notmart/terminalmodelmtousb/freecad/Top.stl

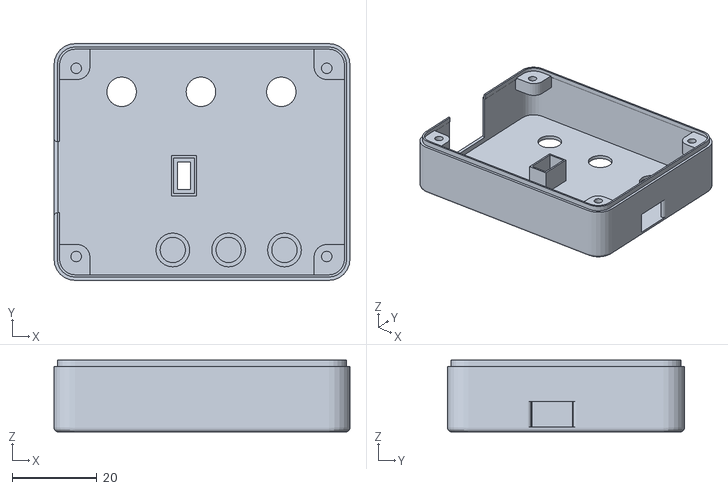
[picture p1: CAD file, 2021-06-11]
freecad/Top.stl
70.0 x 56.0 x 17.0
