notmart/terminalmodelmtousb/kicad/modelMterminalAdapter.step

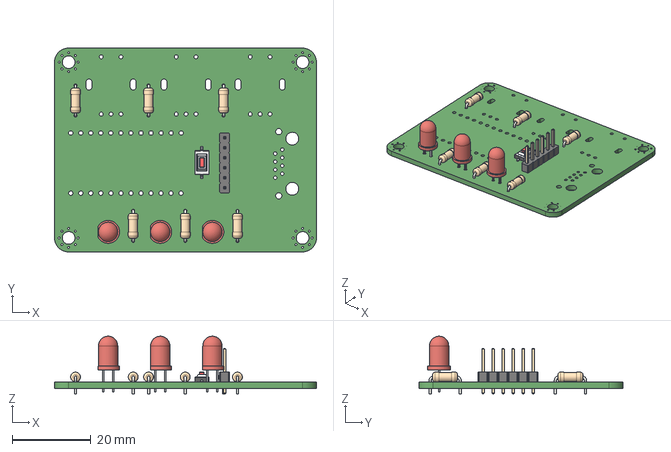
[picture p2: CAD file, 2021-05-25]
kicad/modelMterminalAdapter.step
66.3 x 51.6 x 14.6 mm
