notmart/terminalmodelmtousb/freecad/Bottom.stl

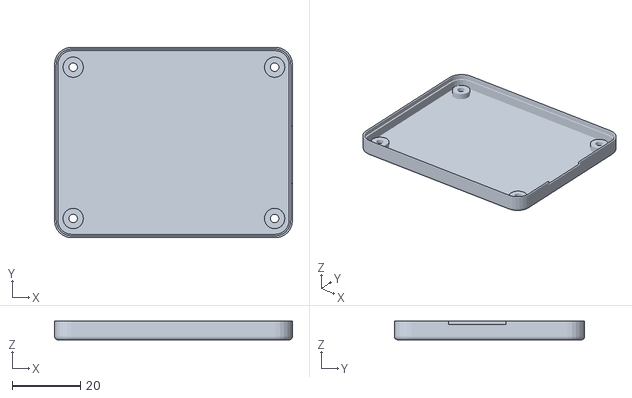
[picture p3: CAD file, 2021-06-11]
freecad/Bottom.stl
70.0 x 56.0 x 5.50
