notmart/terminalmodelmtousb/freecad/case.FCStd

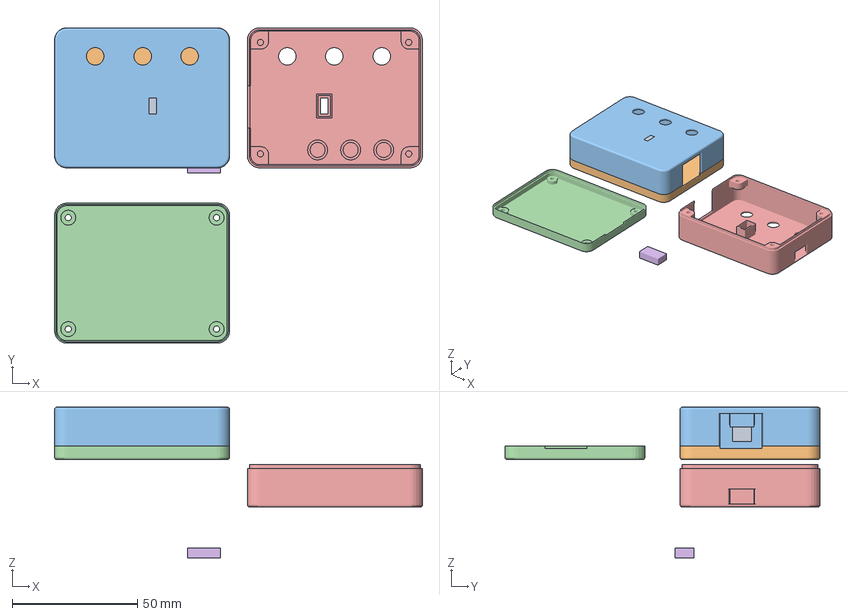
[picture p4: CAD file, 2021-06-11]
freecad/case.FCStd
147.0 x 126.0 x 60.2 mm
ResetButton
Bottom
Top
Bottom (Meshed)
Top (Meshed)
ResetButton (Meshed)
