notmart/terminalmodelmtousb/freecad/ResetButton.stl

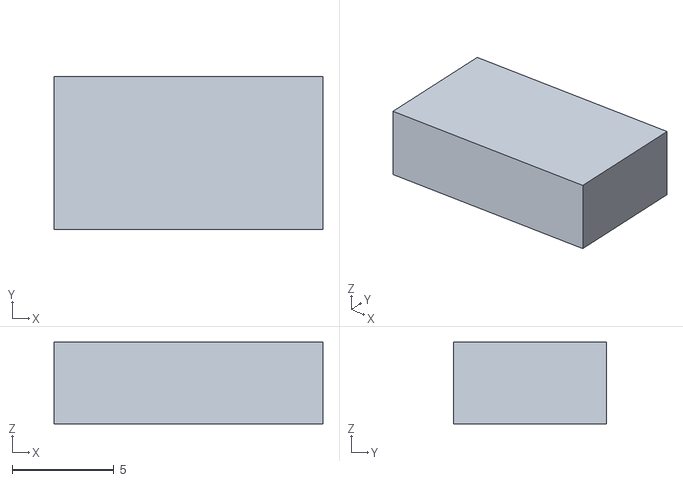
[picture p5: CAD file, 2021-06-11]
freecad/ResetButton.stl
13.2 x 7.50 x 4.00
