notmart/terminalmodelmtousb/kicad/modelMterminalAdapter.kicad_pcb

## KiCad design kicad/modelMterminalAdapter.kicad_pcb (2021-05-25)

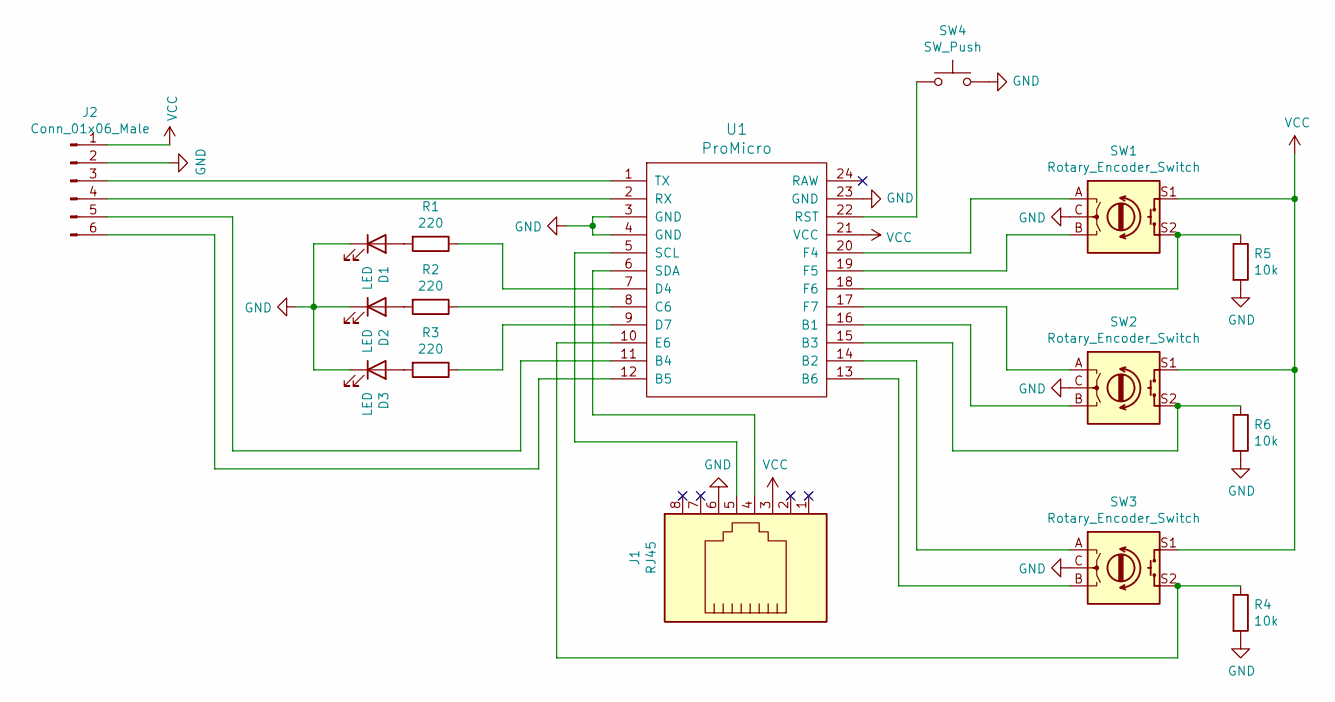
[picture p6: schematic modelMterminalAdapter.sch]

Parts:
D1, D2, D3: LED; LED_D5.0mm
J1: RJ45; RJ45_Amphenol_RJHSE5380
J2: Conn_01x06_Male; PinHeader_1x06_P2.54mm_Vertical
R1, R2, R3: 220; R_Axial_DIN0207_L6.3mm_D2.5mm_P7.62mm_Horizontal
R4, R5, R6: 10k; R_Axial_DIN0207_L6.3mm_D2.5mm_P7.62mm_Horizontal
SW1, SW2, SW3: Rotary_Encoder_Switch; RotaryEncoder_Alps_EC11E-Switch_Vertical_H20mm
SW4: SW_Push; SW_SPST_CK_RS282G05A3
U1: ProMicro

Connections:
GND: D1.1 (K), D2.1 (K), D3.1 (K), J1.6, J2.2, R4.2, R5.2, R6.2, SW1.C, SW2.C, SW3.C, SW4.2, U1.3 (GND), U1.4 (GND), U1.23 (GND)
unnamed: D1.2 (A), R1.2
unnamed: D2.2 (A), R2.2
unnamed: D3.2 (A), R3.2
unnamed: J1.4, U1.6 (SDA)
unnamed: J1.5, U1.5 (SCL)
unnamed: J2.3, U1.1 (TX)
unnamed: J2.4, U1.2 (RX)
unnamed: J2.5, U1.11 (B4)
unnamed: J2.6, U1.12 (B5)
unnamed: R1.1, U1.7 (D4)
unnamed: R2.1, U1.8 (C6)
unnamed: R3.1, U1.9 (D7)
unnamed: R4.1, SW3.S2, U1.10 (E6)
unnamed: R5.1, SW1.S2, U1.18 (F6)
unnamed: R6.1, SW2.S2, U1.15 (B3)
unnamed: SW1.A, U1.20 (F4)
unnamed: SW1.B, U1.19 (F5)
unnamed: SW2.A, U1.17 (F7)
unnamed: SW2.B, U1.16 (B1)
unnamed: SW3.A, U1.14 (B2)
unnamed: SW3.B, U1.13 (B6)
unnamed: SW4.1, U1.22 (RST)
VCC: J1.3, J2.1, SW1.S1, SW2.S1, SW3.S1, U1.21 (VCC)

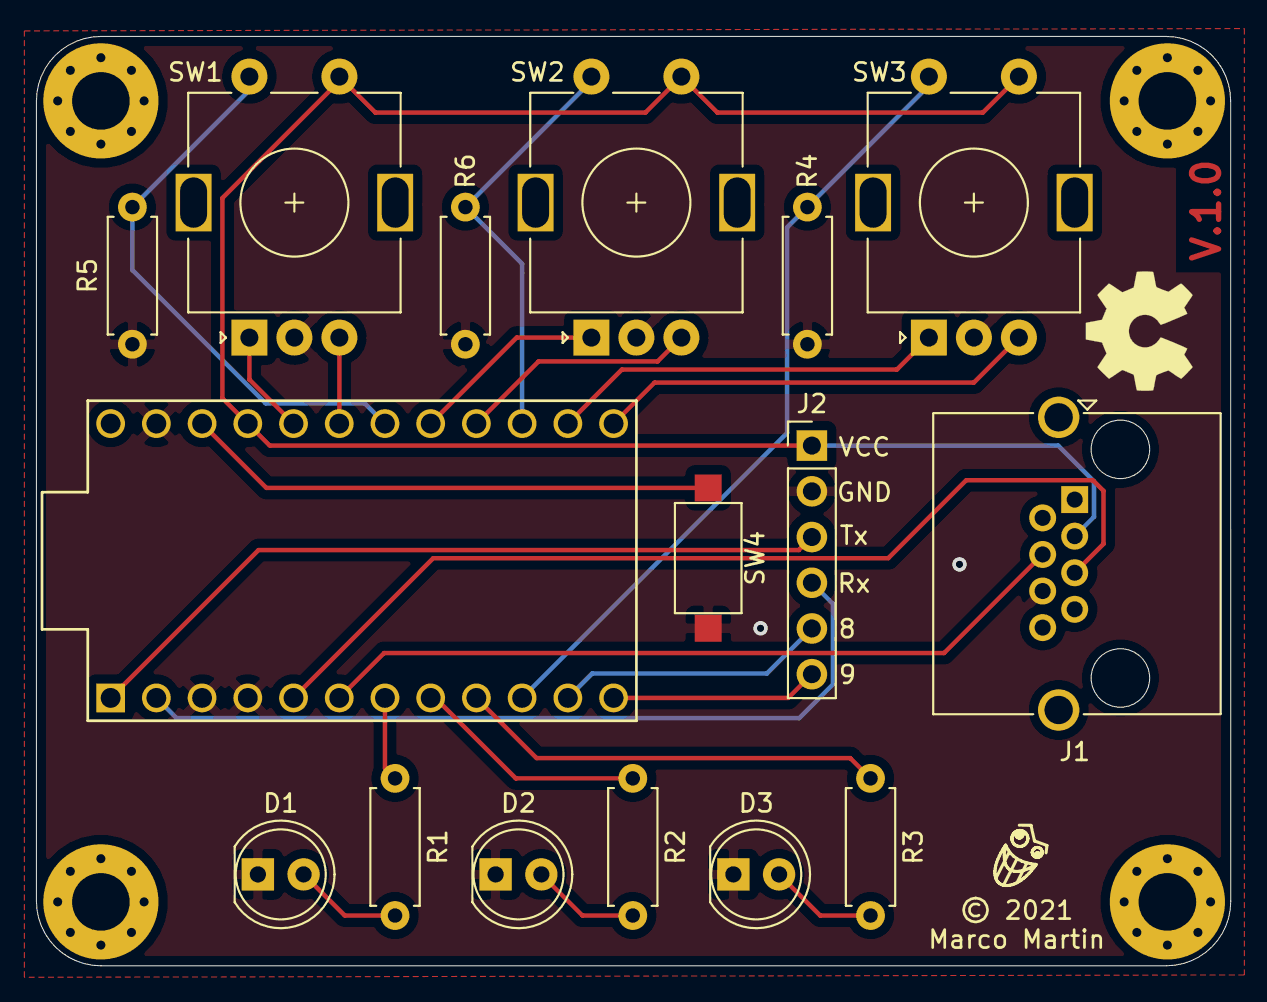
[picture p7: board modelMterminalAdapter.kicad_pcb from above]

Board: 2 copper layers, 66.4 x 51.6 mm, 20 parts (0 on the bottom side), 24 nets.

Other parts of the board:
mount1, mount2, mount3, mount4: MountingHole_3.2mm_M3_Pad_Via
