notmart/terminalmodelmtousb/terminalmodelmtousb.ino

/*
 *   Copyright 2021 Marco Martin <mart@kde.org>
 *
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
 *   You should have received a copy of the GNU Library General Public
 *   License along with this program; if not, write to the
 *   Free Software Foundation, Inc.,
 *   51 Franklin Street, Fifth Floor, Boston, MA  02110-1301, USA.
 */

// Depends upon https://github.com/NicoHood/HID
#include "HID-Project.h"

#include "KeyTable.h"
#include "MacroTable.h"
#include "Ps2Protocol.hh"
#include "PollingEncoder.hh"

// when turned on keyboard sends AA BF B6 when this equals 3 all 3 codes arrived
// default to sequence done for now, investigate how to always make it send the sequence
// even when starts together with the arduino
static volatile uint8_t aabfb6_status = 0;

// Macros are funcion pointers
static void (*macro_to_execute)() = nullptr;


#define DATA_PIN 3
#define IRQ_PIN 2

#define numLockLed 6
#define capsLed 5
#define scrollLed 4


PollingEncoder encoder1(10, 16, 7);
PollingEncoder encoder2(15, 18, 14);
PollingEncoder encoder3(20, 21, 19);

void setup() {
    setup_key_table();
    setup_macro_table();
    Serial.begin(9600);

    BootKeyboard.begin();

    pinMode(IRQ_PIN, INPUT_PULLUP);
    pinMode(DATA_PIN, INPUT_PULLUP);

    Ps2Protocol.begin(IRQ_PIN, DATA_PIN);

    // Ask the keyboard to send Make and Break codes (in case it's already connected)
    Ps2Protocol.sendMessage(0xF8);
}

void loop() {
    PollingEncoder::Direction enc1Direction = encoder1.pollDirection();

    switch (enc1Direction) {
    case PollingEncoder::Left:
        BootKeyboard.write(KEY_LEFT_ARROW);
        break;
    case PollingEncoder::Right:
        BootKeyboard.write(KEY_RIGHT_ARROW);
        break;
    default:
        break;
    }

    switch(encoder1.pollButton()) {
    case PollingEncoder::Pressed:
        BootKeyboard.press(KEY_SPACE);
        break;
    case PollingEncoder::Released:
        BootKeyboard.release(KEY_SPACE);
        break;
    default:
        break;
    }

    PollingEncoder::Direction enc2Direction = encoder2.pollDirection();

    switch (enc2Direction) {
    case PollingEncoder::Left:
        BootKeyboard.press(KEY_LEFT_CTRL);
        BootKeyboard.write(KEY_Z);
        BootKeyboard.release(KEY_LEFT_CTRL);
        break;
    case PollingEncoder::Right:
        BootKeyboard.press(KEY_LEFT_CTRL);
        BootKeyboard.press(KEY_LEFT_SHIFT);
        BootKeyboard.write(KEY_Z);
        BootKeyboard.release(KEY_LEFT_SHIFT);
        BootKeyboard.release(KEY_LEFT_CTRL);
        break;
    default:
        break;
    }

    if (encoder2.pollButton() == PollingEncoder::Pressed) {
        BootKeyboard.press(KEY_LEFT_CTRL);
        BootKeyboard.write(KEY_S);
        BootKeyboard.release(KEY_LEFT_CTRL);
    }

    PollingEncoder::Direction enc3Direction = encoder3.pollDirection();

    switch (enc3Direction) {
    case PollingEncoder::Left:
        BootKeyboard.write(KEY_VOLUME_DOWN);
        break;
    case PollingEncoder::Right:
        BootKeyboard.write(KEY_VOLUME_UP);
        break;
    default:
        break;
    }

    switch(encoder3.pollButton()) {
    case PollingEncoder::Pressed:
        BootKeyboard.press(KEY_MUTE);
        break;
    case PollingEncoder::Released:
        BootKeyboard.release(KEY_MUTE);
        break;
    default:
        break;
    }

    sync_leds();

    static bool next_is_break = false;
    uint8_t scan_code = Ps2Protocol.popScancode();

    if (scan_code) {
       // Serial.println(scan_code, HEX);

        switch (aabfb6_status) {
        case 0:
            if (scan_code == 0xAA) {
                aabfb6_status = 1;
                return;
            }
            break;
        case 1:
            if (scan_code == 0xBF) {
                aabfb6_status = 2;
            }
            return;
        case 2:
            if (scan_code == 0xB6) {
                aabfb6_status = 0;
               // Ask the keyboard to send Make and Break codes
               Ps2Protocol.sendMessage(0xF8);
            }
            return;  
        case 3:
        default:
            break;
        }

        // Scancode mapping
        switch (scan_code) {
        case 0xF0:
            next_is_break = true;
            break;
        default:
            macro_to_execute = macro_table[scan_code];

            if (next_is_break) {
                if (macro_to_execute) {
                    macro_to_execute();
                } else {
                    BootKeyboard.release(key_table[scan_code]);
                }
            } else if (macro_to_execute == nullptr) {
                BootKeyboard.press(key_table[scan_code]);
            }
            next_is_break = false;
        }

        next_is_break = scan_code == 0xF0;
    }
}

inline void sync_leds()
{
    const uint8_t ledsStatus = BootKeyboard.getLeds();
    if (ledsStatus & LED_NUM_LOCK) {
        digitalWrite(numLockLed, HIGH);
    } else {
        digitalWrite(numLockLed, LOW);
    }
    if (ledsStatus & LED_CAPS_LOCK) {
        digitalWrite(capsLed, HIGH);
    } else {
        digitalWrite(capsLed, LOW);
    }
    if (ledsStatus & LED_SCROLL_LOCK) {
        digitalWrite(scrollLed, HIGH);
    } else {
        digitalWrite(scrollLed, LOW);
    }
}
