notmart/terminalmodelmtousb/MacroTable.h

#ifndef MACROTABLE_H
#define MACROTABLE_H

#include "HID-Project.h"

//static void* macro_table[256];

static void (*macro_table[256])();

void macro_compose_key()
{
    BootKeyboard.press(KEY_RIGHT_ALT);
    BootKeyboard.write(KEY_MENU);
    BootKeyboard.release(KEY_RIGHT_ALT);
}

void macro_1()
{
    BootKeyboard.println("git pull --rebase");
}

void macro_2()
{
    
}

void macro_3()
{
    BootKeyboard.println("git push");
}

void macro_4()
{
    
}

void macro_5()
{
    
}

void macro_6()
{
    
}

void macro_7()
{
    
}

void macro_8()
{
    
}

void macro_9()
{
    
}


void setup_macro_table()
{
    //default to zero which won't send anything
    for (int i = 0; i < 256; ++i) {
        macro_table[i] = nullptr;
    }

    // Numer row
    macro_table[0xE] = nullptr;
    macro_table[0x16] = nullptr;
    macro_table[0x1E] = nullptr;
    macro_table[0x26] = nullptr;
    macro_table[0x25] = nullptr;
    macro_table[0x2E] = nullptr;
    macro_table[0x36] = nullptr;
    macro_table[0x3D] = nullptr;
    macro_table[0x3E] = nullptr;
    macro_table[0x46] = nullptr;
    macro_table[0x45] = nullptr;
    macro_table[0x4E] = nullptr;
    macro_table[0x55] = nullptr;

    // Q ROW
    macro_table[0x15] = nullptr;
    macro_table[0x1D] = nullptr;
    macro_table[0x24] = nullptr;
    macro_table[0x2D] = nullptr;
    macro_table[0x2C] = nullptr;
    macro_table[0x35] = nullptr;
    macro_table[0x3C] = nullptr;
    macro_table[0x43] = nullptr;
    macro_table[0x44] = nullptr;
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
    macro_table[0x04] = nullptr;
    macro_table[0x0C] = nullptr;
    macro_table[0x03] = macro_3;
    macro_table[0x0B] = macro_2;
    macro_table[0x83] = macro_1;
    macro_table[0x0A] = macro_compose_key;
    macro_table[0x01] = nullptr;
    macro_table[0x09] = nullptr;
}

#endif
