notmart/terminalmodelmtousb/(commit log)

2021-05-25 add basic support for a rotary encoder
2021-05-25 add a Kicad project for a pcb based on pro micro
    [modelMterminalAdapter-B_Cu.gbr, modelMterminalAdapter-B_Mask.gbr, modelMterminalAdapter-B_Paste.gbr, modelMterminalAdapter-B_SilkS.gbr, modelMterminalAdapter-Edge_Cuts.gbr, modelMterminalAdapter-F_Cu.gbr, modelMterminalAdapter-F_Mask.gbr, modelMterminalAdapter-F_Paste.gbr]
2021-05-25 library for a basic polling-based encoder
2021-06-11 support for polling button presses
2021-06-11 update 3d model
    [Bottom.stl, ResetButton.stl, Top.stl, case.FCStd]
2021-06-25 update the led pins
2022-01-19 add software debounce for encoder buttons
