notmart/terminalmodelmtousb/(notices)

Notices in the files:
terminalmodelmtousb.ino:
This program is free software; you can redistribute it and/or modify
it under the terms of the GNU Library General Public License as
published by the Free Software Foundation; either version 2, or
(at your option) any later version.
kicad/modelMterminalAdapter.kicad_pcb:
© 2021
